lota09/AutoExhaust/docs/ESP32_C3_Pinmap.png

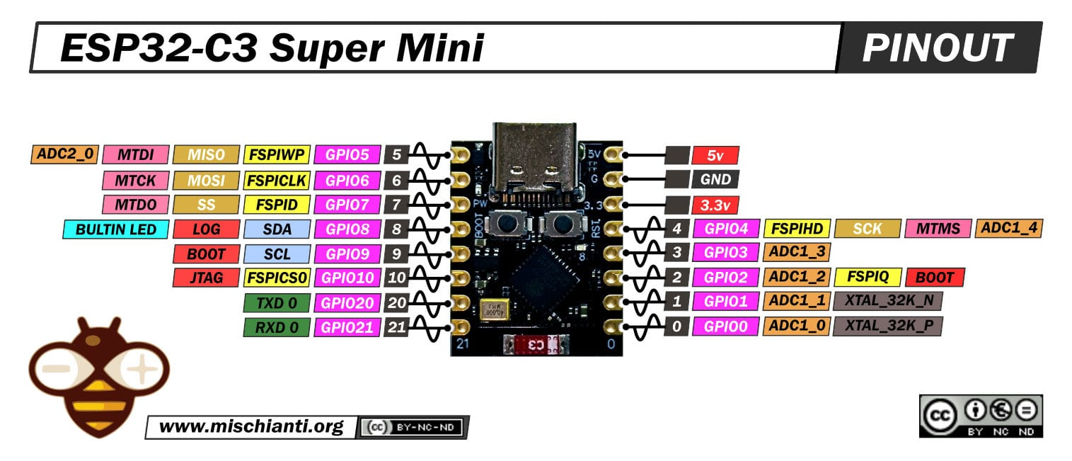
docs/ESP32_C3_Pinmap.png
