lota09/AutoExhaust/docs/ESP32_C3_Pinmap_rear.png

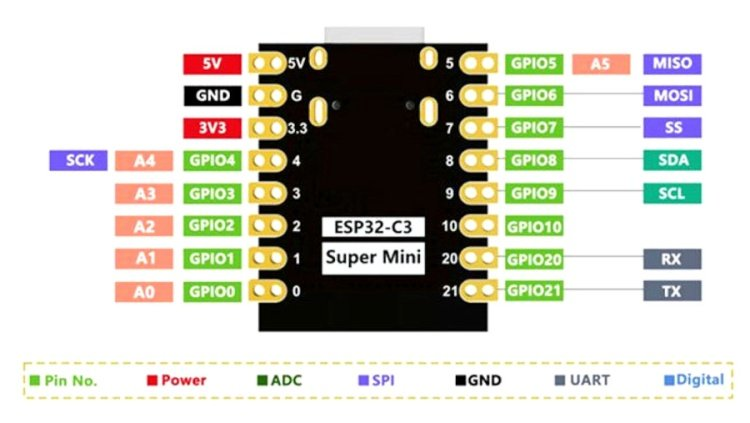
docs/ESP32_C3_Pinmap_rear.png
