lota09/AutoExhaust/hardware/bom/voltage_solution.pdf

# 전압 변환 솔루션 (Voltage Converters Comparison)

다양한 DC-DC 컨버터 모듈의 스펙과 특징을 비교하는 문서입니다.

📊 스펙 비교표

제품명 | 유형

입력 전압
(Input)

출력 전압
(Output)

최대 전
류

효율
(Max)

단가 (약) 특징 & 비고

Mini-360

Buck
(감압)

DC 4.75V
~ 23V

DC 1.0V ~
17V

3A
(Peak)
1.8A
(Cont)

96% 350원

초소형
(17x11mm), 동기

식 정류
장시간 사용시
1.8A 제한

MP1584EN

Buck
(감압)

DC 4.5V
~ 28V

DC 0.8V ~
20V
3A | 92% | 583원

초소형
(22x17mm), 고주
파(1.5MHz)
저전압 리플, 역극
성/무부하 주의

LM2596

Buck
(감압)

DC 3.2V
~ 35V

DC 1.25V
~ 30V

3A 92%

680~1,030

원

입력전압이 출력보
다 1.5V 높아야 함
단락/과열 보호, 전
원 LED 장착

MT3608

Boost
(승압)

DC 2V ~
24V

DC 5V ~
28V

2A
(Peak)

93% 450원

Micro USB /
Type-C 입력 가능
초기 세팅 주의 (반
시계 20바퀴)

XL6009

Buck-Boost
(자동
승강압)

DC 3.8V
~ 32V

DC 1.25V
~ 35V

3A
(Max
4A)

<94%

800~1,130

원

입력 전압이 출력
보다 높거나 낮아
도 OK
태양광/차량용 전

압 안정화 최적

XL6019

Buck-Boost
(자동
승강압)

DC 5V ~
32V

DC 1.3V ~
35V

1.5A
(Cont)
Max
4A

94% 1,250원

XL6009의 개량형
(발열/노이즈 개선)
내장 MOSFET 성

능 향상

LTC3780

Buck-Boost
(자동
승강압)

DC 5V ~
32V

DC 1V ~
30V

8A
(Cont)
Max
10A
- 12,000원

끝판왕 (고출력
80W~130W)
단락 보호 O, 역극
성 보호 X

️ 제품 이미지 및 상세

26. 2. 14. 오후 7:19 | voltage_solution.md
file:///C:/Users/lota/Developments/3D_Firmware/BOM/voltage_solution.html | 1/8

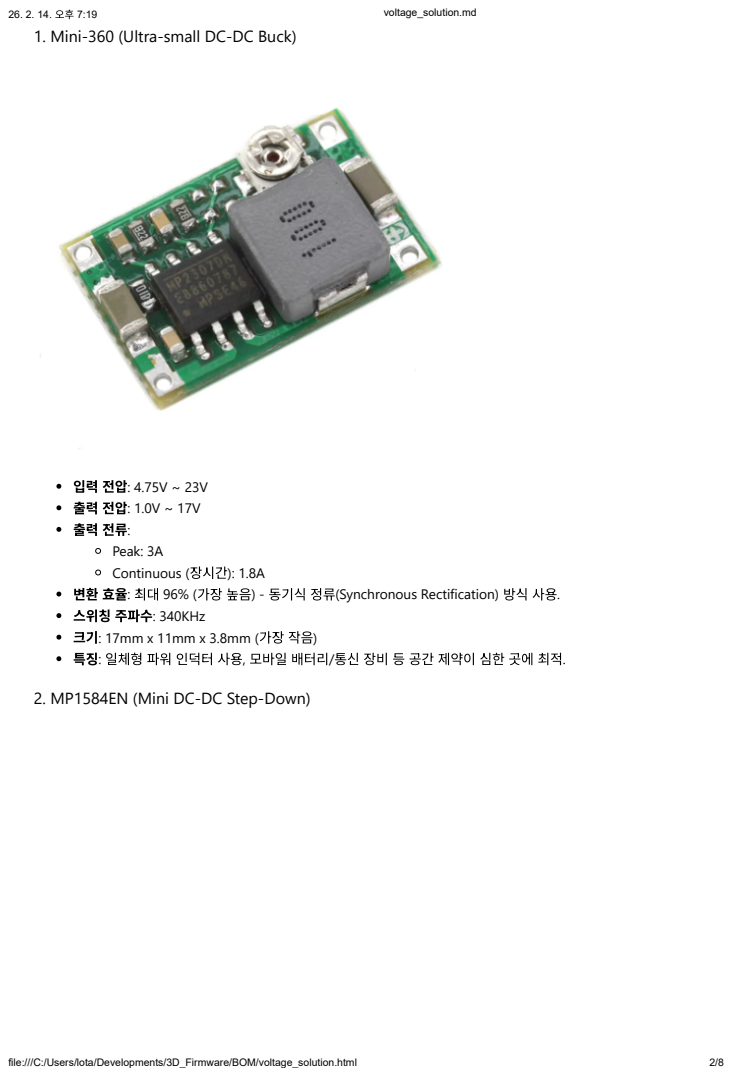
[picture p9: page 2]
file:///C:/Users/lota/Developments/3D_Firmware/BOM/voltage_solution.html

1. Mini-360 (Ultra-small DC-DC Buck)

Peak: 3A
Continuous (장시간): 1.8A
변환 효율: 최대 96% (가장 높음) - 동기식 정류(Synchronous Rectification) 방식 사용.
스위칭 주파수: 340KHz
특징: 일체형 파워 인덕터 사용, 모바일 배터리/통신 장비 등 공간 제약이 심한 곳에 최적.
2. MP1584EN (Mini DC-DC Step-Down)

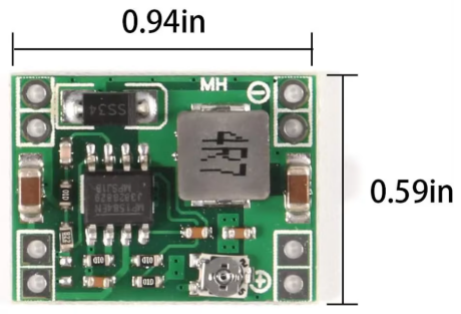
[picture p10: figure]

입력 전압: 4.5V ~ 28V (최대)
출력 전압: 0.8V ~ 20V (가변)
스위칭 주파수: 1.5MHz (일반 1MHz) - 고주파 동작으로 리플이 적음.
출력 리플: < 30mV
크기: 22mm x 17mm x 4mm (초소형)
주의사항:
역극성 금지: (+)와 (-)를 반대로 연결하면 즉시 파손됨.
무부하 금지: 부하가 없거나 너무 가벼운(10% 미만) 상태로 켜지 마세요.
3. LM2596 (DC-DC Step-Down)
file:///C:/Users/lota/Developments/3D_Firmware/BOM/voltage_solution.html | 3/8

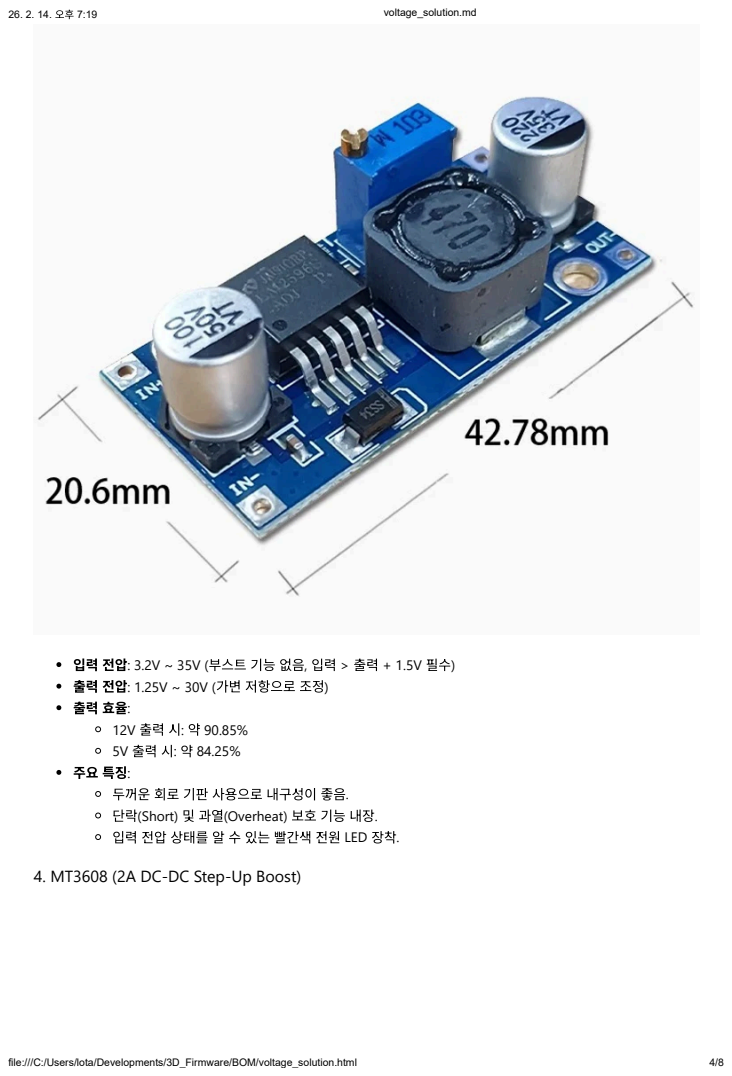
[picture p11: page 4]
file:///C:/Users/lota/Developments/3D_Firmware/BOM/voltage_solution.html

입력 전압: 3.2V ~ 35V (부스트 기능 없음, 입력 > 출력 + 1.5V 필수)
출력 전압: 1.25V ~ 30V (가변 저항으로 조정)
두꺼운 회로 기판 사용으로 내구성이 좋음.
단락(Short) 및 과열(Overheat) 보호 기능 내장.
입력 전압 상태를 알 수 있는 빨간색 전원 LED 장착.

4. MT3608 (2A DC-DC Step-Up Boost)

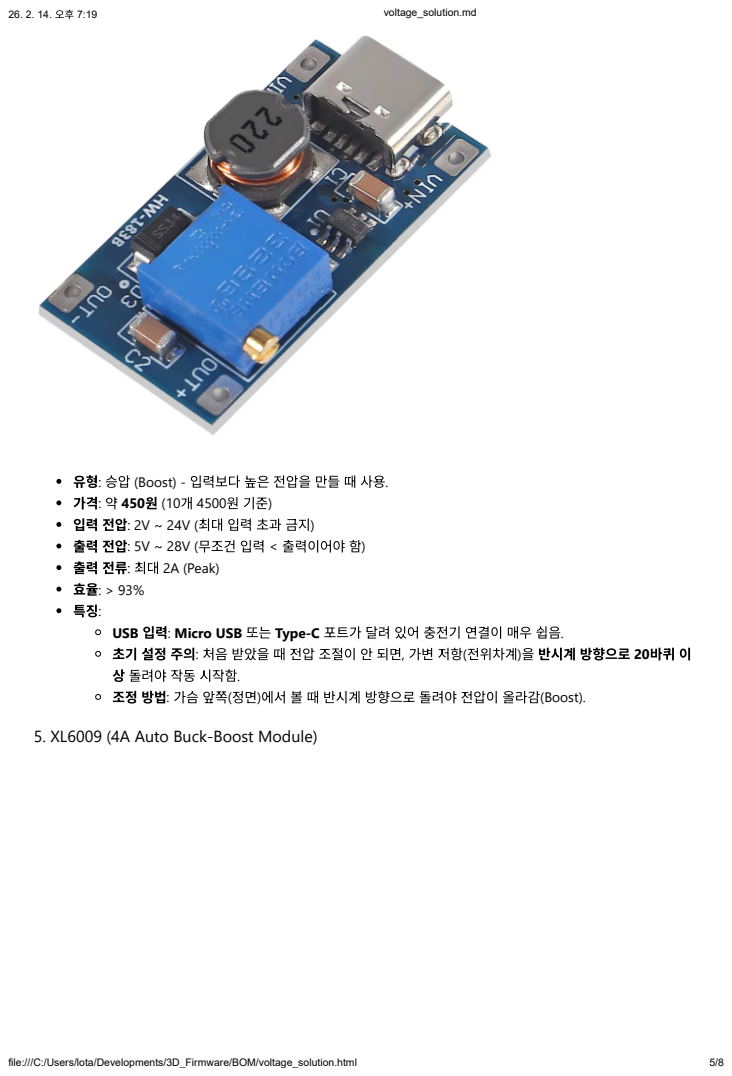
[picture p12: page 5]
file:///C:/Users/lota/Developments/3D_Firmware/BOM/voltage_solution.html

유형: 승압 (Boost) - 입력보다 높은 전압을 만들 때 사용.
출력 전압: 5V ~ 28V (무조건 입력 < 출력이어야 함)
출력 전류: 최대 2A (Peak)
USB 입력: Micro USB 또는 Type-C 포트가 달려 있어 충전기 연결이 매우 쉽음.
초기 설정 주의: 처음 받았을 때 전압 조절이 안 되면, 가변 저항(전위차계)을 반시계 방향으로 20바퀴 이
상 돌려야 작동 시작함.
조정 방법: 가슴 앞쪽(정면)에서 볼 때 반시계 방향으로 돌려야 전압이 올라감(Boost).

5. XL6009 (4A Auto Buck-Boost Module)

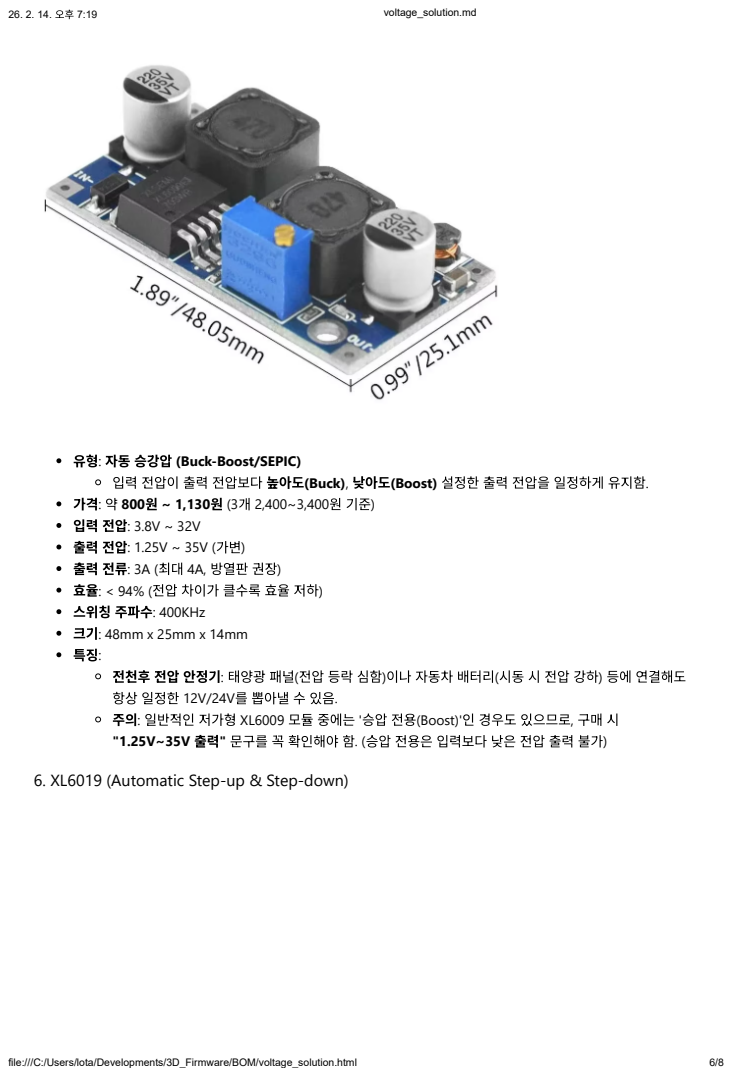
[picture p13: page 6]
file:///C:/Users/lota/Developments/3D_Firmware/BOM/voltage_solution.html

유형: 자동 승강압 (Buck-Boost/SEPIC)
입력 전압이 출력 전압보다 높아도(Buck), 낮아도(Boost) 설정한 출력 전압을 일정하게 유지함.
출력 전류: 3A (최대 4A, 방열판 권장)
효율: < 94% (전압 차이가 클수록 효율 저하)
스위칭 주파수: 400KHz
전천후 전압 안정기: 태양광 패널(전압 등락 심함)이나 자동차 배터리(시동 시 전압 강하) 등에 연결해도
항상 일정한 12V/24V를 뽑아낼 수 있음.
주의: 일반적인 저가형 XL6009 모듈 중에는 '승압 전용(Boost)'인 경우도 있으므로, 구매 시
"1.25V~35V 출력" 문구를 꼭 확인해야 함. (승압 전용은 입력보다 낮은 전압 출력 불가)

6. XL6019 (Automatic Step-up & Step-down)

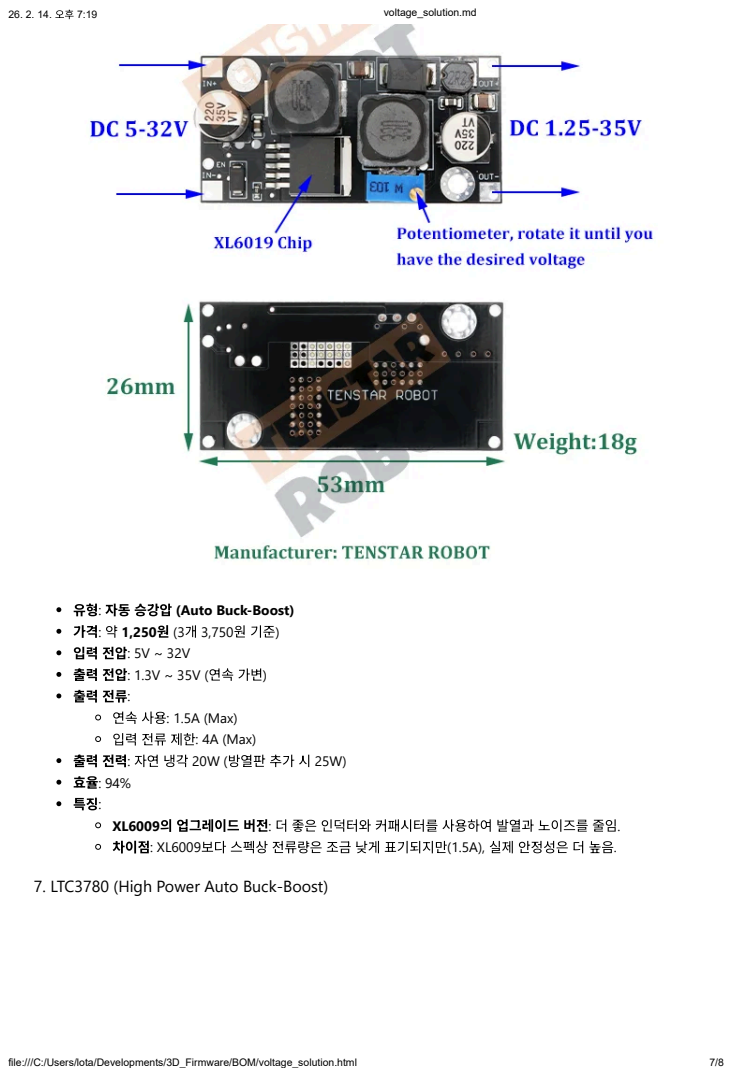
[picture p14: page 7]
file:///C:/Users/lota/Developments/3D_Firmware/BOM/voltage_solution.html

유형: 자동 승강압 (Auto Buck-Boost)
연속 사용: 1.5A (Max)
입력 전류 제한: 4A (Max)
출력 전력: 자연 냉각 20W (방열판 추가 시 25W)
XL6009의 업그레이드 버전: 더 좋은 인덕터와 커패시터를 사용하여 발열과 노이즈를 줄임.
차이점: XL6009보다 스펙상 전류량은 조금 낮게 표기되지만(1.5A), 실제 안정성은 더 높음.

7. LTC3780 (High Power Auto Buck-Boost)

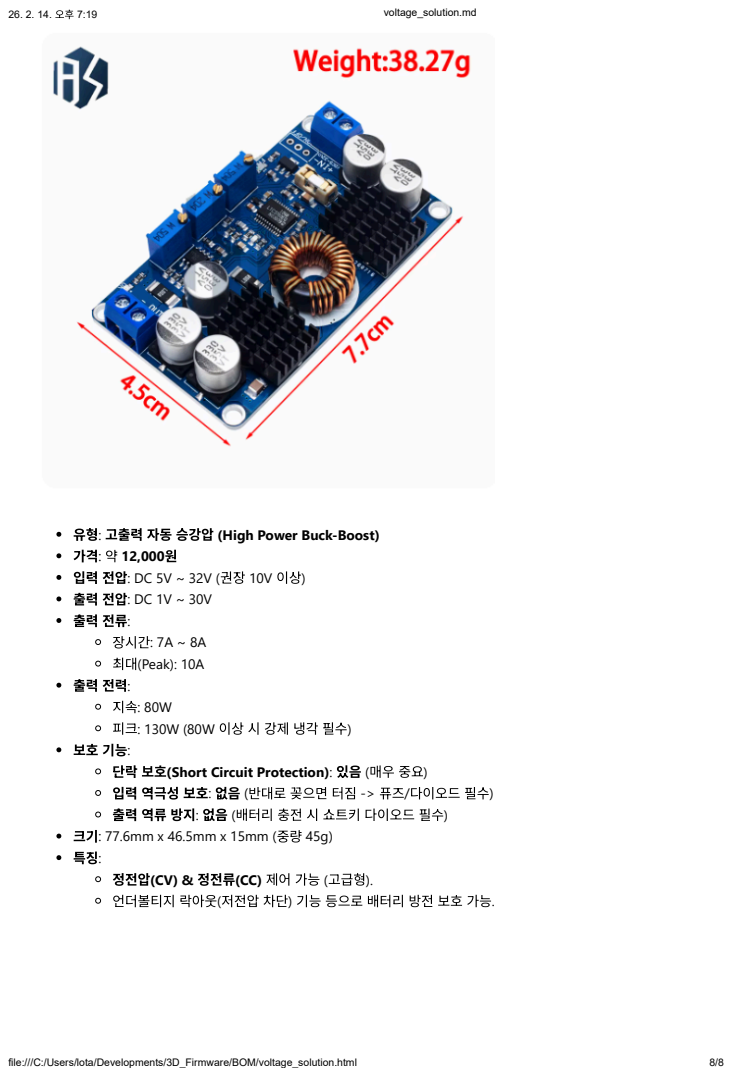
[picture p15: page 8]
file:///C:/Users/lota/Developments/3D_Firmware/BOM/voltage_solution.html

유형: 고출력 자동 승강압 (High Power Buck-Boost)
장시간: 7A ~ 8A
최대(Peak): 10A
단락 보호(Short Circuit Protection): 있음 (매우 중요)
입력 역극성 보호: 없음 (반대로 꽂으면 터짐 -> 퓨즈/다이오드 필수)
출력 역류 방지: 없음 (배터리 충전 시 쇼트키 다이오드 필수)
정전압(CV) & 정전류(CC) 제어 가능 (고급형).
언더볼티지 락아웃(저전압 차단) 기능 등으로 배터리 방전 보호 가능.
