lota09/AutoExhaust/hardware/bom/LTC3780.png

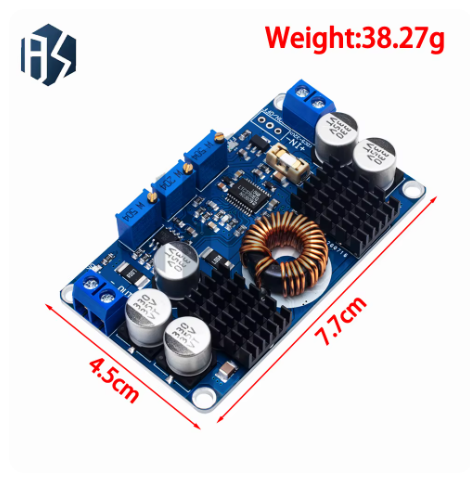
hardware/bom/LTC3780.png
