lota09/AutoExhaust/hardware/bom/MT3608.png

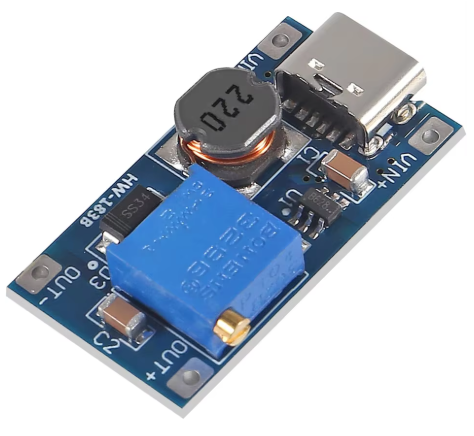
hardware/bom/MT3608.png
