lota09/AutoExhaust/hardware-tests/WiFi_Signal_Analyzer/signal_strength.md

## New Device : bare

```
22:06:11.944 -> Local: -66.0 dBm | Remote: -100.0 dBm
22:06:16.927 -> Local: -62.0 dBm | Remote: -100.0 dBm
22:06:21.965 -> Local: -68.0 dBm | Remote: -100.0 dBm
22:06:26.929 -> Local: -62.0 dBm | Remote: -100.0 dBm
22:06:31.957 -> Local: -71.0 dBm | Remote: -100.0 dBm
22:06:36.977 -> Local: -71.0 dBm | Remote: -100.0 dBm
22:06:41.987 -> Local: -71.0 dBm | Remote: -100.0 dBm
22:06:46.966 -> Local: -66.0 dBm | Remote: -100.0 dBm
22:06:51.975 -> Local: -70.0 dBm | Remote: -100.0 dBm
22:06:57.036 -> Local: -68.0 dBm | Remote: -100.0 dBm
22:07:02.011 -> Local: -77.0 dBm | Remote: -100.0 dBm
22:07:07.006 -> Local: -69.0 dBm | Remote: -100.0 dBm
22:07:12.044 -> Local: -67.0 dBm | Remote: -100.0 dBm
```

## New Device : bshape_antenna

```
..........
WiFi Connected: 192.168.50.161
Local: -64.0 dBm | Remote: -100.0 dBm
Local: -61.0 dBm | Remote: -100.0 dBm
Local: -61.0 dBm | Remote: -100.0 dBm
Local: -64.0 dBm | Remote: -100.0 dBm
Local: -67.0 dBm | Remote: -100.0 dBm
Local: -62.0 dBm | Remote: -100.0 dBm
Local: -65.0 dBm | Remote: -100.0 dBm
Local: -66.0 dBm | Remote: -100.0 dBm
Local: -64.0 dBm | Remote: -100.0 dBm
Local: -64.0 dBm | Remote: -100.0 dBm
Local: -64.0 dBm | Remote: -100.0 dBm
Local: 0.0 dBm | Remote: -100.0 dBm
Local: -65.0 dBm | Remote: -100.0 dBm
Local: -65.0 dBm | Remote: -100.0 dBm
Local: -65.0 dBm | Remote: -100.0 dBm
Local: -65.0 dBm | Remote: -100.0 dBm
Local: -65.0 dBm | Remote: -100.0 dBm
Local: -65.0 dBm | Remote: -100.0 dBm
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
Local: -74.0 dBm | Remote: -100.0 dBm
Local: -73.0 dBm | Remote: -100.0 dBm
Local: -73.0 dBm | Remote: -100.0 dBm
Local: -86.0 dBm | Remote: -100.0 dBm
Local: -77.0 dBm | Remote: -100.0 dBm
Local: -71.0 dBm | Remote: -100.0 dBm
Local: -76.0 dBm | Remote: -100.0 dBm
```

## Phoenix(old) Device : Wshape_antenna_L
```
22:58:59.082 -> .......................................................................................................
22:59:50.846 -> WiFi Connected: 192.168.50.75
22:59:50.846 -> mDNS responder started: http://wifianalyzer.local
23:00:02.865 -> Local: -79.0 dBm | Remote: -100.0 dBm
23:00:09.865 -> Local: -73.0 dBm | Remote: -100.0 dBm
23:00:16.877 -> Local: -74.0 dBm | Remote: -100.0 dBm
23:00:23.863 -> Local: -81.0 dBm | Remote: -100.0 dBm
```
