lota09/AutoExhaust/hardware-tests/WiFi_Stability/logs/boot_test_20261027_142339.csv

trial | profile | boot_connect_ms | failed_attempts | web_up_s | mqtt_up_s | rssi_now | rssi_avg | tx_dbm | channel
1 | P1 | 5155 | 0 | 10 | 10 | -70 | -70.4 | 19.5 | 6
2 | P2 | 5088 | 0 | 9 | 9 | -70 | -70.5 | 11.0 | 6
3 | P3 | 5091 | 0 | 8 | 8 | -47 | -69.0 | 8.5 | 6
4 | P2 | 4582 | 0 | 8 | 8 | -71 | -71.7 | 11.0 | 6
5 | P3 | 5097 | 0 | 8 | 9 | -71 | -71.3 | 8.5 | 6
6 | P1 | 5120 | 0 | 9 | 9 | -72 | -72.0 | 19.5 | 6
7 | P3 | 5152 | 0 | 8 | 8 | -73 | -71.5 | 8.5 | 6
8 | P1 | 5129 | 0 | 10 | 10 | -73 | -72.1 | 19.5 | 6
9 | P2 | 5123 | 0 | 9 | 9 | -72 | -71.7 | 11.0 | 6
10 | P1 | 5122 | 0 | 8 | 9 | -71 | -71.6 | 19.5 | 6
11 | P2 | 5122 | 0 | 9 | 9 | -72 | -72.0 | 11.0 | 6
12 | P3 | 5122 | 0 | 8 | 8 | -72 | -71.9 | 8.5 | 6
13 | P2 | 4591 | 0 | 8 | 8 | -73 | -71.2 | 11.0 | 6
14 | P3 | 5094 | 0 | 8 | 9 | -73 | -72.4 | 8.5 | 6
15 | P1 | 5115 | 0 | 9 | 9 | -73 | -72.9 | 19.5 | 6
