lota09/AutoExhaust/docs/powerfailure_solution.md

# ⚡ 전원 보호 솔루션 및 MOSFET 심층 분석

본 문서는 MOSFET 모듈의 종류, 작동 원리(물성), 그리고 MCU를 고전압 사고로부터 보호하기 위한 회로 설계 전략을 다룹니다. 특히 **포토커플러(Optocoupler)**를 활용한 절연 방식과 **N-Channel MOSFET** 구동 원리에 집중합니다.

---

## 1. 포토커플러 (Optocoupler)의 원리

포토커플러는 **"빛을 이용해 신호를 전달하는 소자"**입니다. 전기적으로 완전히 분리된 두 회로를 연결할 때 사용합니다.

### 🔬 구조 및 작동 원리 (PC817 기준)
*   **왼쪽 (입력부: 송신)**: **적외선 LED**
    *   MCU가 신호(High)를 주면 LED가 켜집니다.
    *   반드시 전류 제한 저항(220Ω~1kΩ)이 필요합니다.
*   **중간 (절연체)**: 투명한 **유리/플라스틱**
    *   전기가 통하지 않습니다. (빛만 통과)
    *   입력부에서 수천 볼트 스파크가 튀어도 출력부로 넘어갈 수 없습니다.
*   **오른쪽 (출력부: 수신)**: **포토 트랜지스터(Photo-Transistor)**
    *   빛을 받으면 내부에 전자가 생성되어 스위치가 켜집니다(Collector → Emitter 도통).
    *   빛이 없으면 전기가 통하지 않습니다(Switch OFF).

---

## 2. MOSFET 모듈의 종류와 차이점

시중에는 크게 두 가지 형태의 MOSFET 모듈이 존재합니다.

### A. 듀얼 MOSFET 모듈 (비절연형)
*   **대표 모델**: D4184, LR7843 등 (파란색 단자대, 방열판 없음)
*   **구조**: MCU 핀이 저항 하나를 거쳐 MOSFET의 **Gate**와 직결됨.
*   **특징**:
    *   **장점**: 매우 저렴함(200~300원), 반응 속도가 빠름(ns 단위).
    *   **단점**:
        *   **MCU 전압(3.3V/5V)으로 구동**: MOSFET 성능을 100% 발휘 못함 (발열 증가).
        *   **위험성**: MOSFET이 파괴되면 고전압(12V/24V)이 Gate를 타고 MCU로 역류하여 **보드 전체 사망**.

### B. 절연 MOSFET 모듈 (절연형)
*   **대표 모델**: FR120N, LR7843 절연형 (녹색 단자대, PC817 탑재)
*   **구조**: [MCU 신호] → [**포토커플러**] → [12V/24V 전원] → [MOSFET Gate]
*   **특징**:
    *   **장점**:
        *   **MCU 완벽 보호**: 고전압 사고 시 포토커플러만 죽고 MCU는 생존.
        *   **풀파워 구동**: MCU 전압이 아닌 **12V/24V 전원**을 끌어와 Gate를 셌게 열어줌 ($R_{DS(on)}$ 최소화, 발열 감소).
    *   **단점**: 가격이 비쌈(600~1000원), 반응 속도가 상대적으로 느림(μs 단위, ~20kHz).

---

## 3. MOSFET의 물성과 구동 방식

### 💡 왜 대부분 N-Channel MOSFET (Low-Side)을 쓰는가?
부하의 (+)를 끊는 것(High-Side)보다 **(-)를 끊는 것(Low-Side)**이 압도적으로 유리하기 때문입니다.

1.  **동작 조건 ($V_{GS}$)**
    *   N-MOSFET은 **Gate 전압이 Source 전압보다 10V 높아야($V_{GS} > 10V$)** 완전히 켜집니다.
2.  **Low-Side (N-MOS)의 경우**:
    *   **Source**가 **GND(0V)**에 묶여 있습니다.
    *   **Gate**에 **10V**만 주면 켜집니다. (회로 간단)
3.  **High-Side (N-MOS)의 경우**:
    *   **Source**가 부하 때문에 **떠 있습니다.**
    *   스위치를 켜면 Source 전압이 24V로 올라가 버립니다.
    *   계속 켜려면 Gate에 **34V (24V + 10V)**를 줘야 합니다. (승압 회로 필요 → 비쌈)
4.  **P-Channel MOSFET**:
    *   High-Side 제어가 쉽지만, N-MOS 대비 **가격 3배, 성능(전류 용량) 절반**이라 잘 안 씁니다.

### 🔍 절연 모듈에 있는 '빨간 다이오드'의 정체
*   **제너 다이오드 (Zener Diode)**: Gate와 Source 사이에 병렬로 연결됨.
*   **역할**: 절연 모듈은 24V를 Gate 구동 전원으로 씁니다. 하지만 Gate는 20V 넘으면 터집니다.
*   **작동**: 24V가 들어오면 제너 다이오드가 **"15V 이상은 내가 먹을게(Clamping)"** 하여 Gate 전압을 15V로 유지, MOSFET을 보호합니다.

---

## 4. [DIY 솔루션] 듀얼 모듈을 위한 안전장치 회로

기존 듀얼 모듈(비절연)을 버리지 않고, **트랜지스터(2N7000)** 하나로 **절연 모듈급 성능과 안전성**을 확보하는 회로입니다.

### 🛠️ 회로 구성 (NPN 트랜지스터 활용)
이 회로는 **Low-Active** 방식(MCU Low일 때 팬 켜짐)으로 동작합니다.

1.  **Gate 드라이버 (2N7000/NPN)**
    *   **Base(Gate)**: MCU 핀과 연결 (보호저항 1kΩ 추가 추천)
    *   **Emitter(Source)**: GND 연결
    *   **Collector(Drain)**: 듀얼 모듈의 **신호 입력(SIG)** 핀에 연결
2.  **풀업 저항 (10kΩ)**
    *   **12V/24V 전원(+)**와 **듀얼 모듈 SIG 핀** 사이에 연결.
    *   역할: 2N7000이 꺼졌을 때, 12V/24V를 Gate로 보내 **강력하게 턴온** 시킴.

### 🛡️ 안전 분석 (사고 시나리오)
만약 24V 라인에 **50V 스파크**가 튀면 어떻게 되는가?

*   **상황**: 2N7000이 켜져 있는 상태 (팬 꺼짐 명령 중)
*   **10kΩ 풀업 저항의 역할**:
    *   50V 고전압이 들어와도 **10kΩ 저항**이 전압 대부분을 감당합니다.
    *   전류량 제한: $I = 50V / 10,000\Omega = \mathbf{5mA}$.
    *   2N7000으로 흐르는 전류는 고작 5mA뿐이며, **Drain 전압은 거의 0V**로 유지됩니다.
    *   MCU 쪽으로는 아무런 영향이 가지 않습니다.
*   **만약 2N7000이 터진다면?**:
    *   최후의 보루로 MCU 핀 앞에 달아둔 **1kΩ 저항**이 과전류를 막아줍니다.

---

## 5. 결론 및 요약

1.  **PC817**: 빛으로 신호를 전달하여 MCU와 고전압 회로를 완벽하게 격리하는 **최고의 안전장치**.
2.  **절연 모듈**: 12V/24V 전원을 Gate 구동에 사용하여 **발열이 적고 힘이 좋음**. (제너 다이오드로 Gate 보호)
3.  **듀얼 모듈(비절연)**: MCU 전압으로 구동하므로 성능 저하 및 역류 위험 존재.
4.  **DIY 회로**: **[2N7000 + 10kΩ 풀업]** 조합을 쓰면 듀얼 모듈도 **고전압 구동(풀파워)** 및 **MCU 보호**가 가능함.
