lota09/AutoExhaust/docs/notes/esp32_c3_wifi_failure.md

# 🦅 ESP32-C3 SuperMini 외부 간섭 및 기적적 부활 보고서

## 1. 상황 (Situation)
*   **하드웨어 구성**: 
    *   메인 보드: ESP32-C3 SuperMini
    *   전원부: 12V DC 입력 → Mini-360 벅 컨버터 (3.3V~3.5V 세팅)
*   **사고 발생**: 
    *   프로토타입 보드에 실장된 상태에서 Mini-360 역삽입 사고 발생.
    *   이후 USB 연결 시 LDO 발열, 고주파 비명, 연기 발생 및 WiFi 연결(Reason 2, 201, 36) 지속 실패.
    *   **사망 판정**: 하드웨어 파손으로 결론짓고 폐기 직전까지 감.

## 2. 반전 및 결과 (The Resurrection)
*   **적극적 조치**: 다른 보드로 교체하기 위해 해당 ESP32-C3를 **프로토타입 보드에서 완전히 탈거(분리)**.
*   **기적적 부활**: 
    *   단독 상태에서 USB 연결 시 **발열 및 고주파음 즉시 사라짐**.
    *   **WiFi 연결 성공**: 표준 코드로 공유기 및 스마트폰 핫스팟에 즉시 연결됨.
    *   **SoftAP 확인**: `HELP-ME-C3` 신호가 스마트폰 목록에 정상 노출됨.
*   **최종 결론**: **칩 자체는 불사신이었으며, 범인은 외부(프로토타입 보드)에 있었음.**

## 3. 원인 재분석 (Revised Root Causes)

### A. 전원 역류 현상 (Back-feeding through Mini360)
*   **메커니즘**: USB 5V 연결 시 ESP32의 LDO가 생성한 3.3V 전압이 Mini360의 출력단(OUT+)으로 유입됨.
*   **결과**: Mini360 내부의 바디 다이오드를 타고 입력단(IN+, 12V 버스)으로 역류 발생.
*   **실험 증명**: 출력 노드에 3.3V 인가 시 **순간 전류가 최대 1A까지** 치솟으며 12V 라인의 커패시터들을 급격히 충전 시도함 확인. 
*   **증상 연결**: 이 과부하가 ESP32의 LDO(최대 0.5A)를 고문하여 **심한 발열과 무한 재부팅 루프**를 유발. (디코이 모듈의 비명 소리 동반)

### C. 물리적 배치에 따른 안테나 디튜닝 (Antenna Detuning)
*   **발견**: 동일한 칩이라도 주변 금속물(핀헤더, 프로토타입 보드 배선)의 유무에 따라 WiFi 연결 성능이 극명하게 차이 남.
    *   Bare Board: 5초 이내 연결
    *   프로토타입 보드 실장: 40초 이상 소요 또는 연결 불가
*   **원인**: ESP32-C3 SuperMini의 초소형 세라믹 안테나가 주변의 핀헤더와 구리 패턴에 의해 **임피던스 불일치(Detuning)** 및 신호 차폐 현상을 겪음. [참고자료](https://www.elektormagazine.com/labs/esp32-c3-supermini-antenna-mod)
*   **기묘한 반전 (Human Antenna Effect)**: 안테나 부위를 손으로 쓰다듬거나 접촉할 경우 연결 속도가 **5~15초로 획기적으로 향상**됨. 이는 인체가 안테나의 연장선 혹은 튜닝 보정기 역할을 하여 신호를 강제로 외부로 유도했기 때문임.

## 4. 재발 방지 및 향후 대책 (New Lessons)

### 🛡️ 하드웨어 보호 및 RF 최적화
*   **역류 방지**: 벅 컨버터 출력단(OUT+)에 **쇼트키 다이오드(1n5819)**를 추가하여 USB 전원의 외부 역류를 물리적으로 차단.
*   **안테나 이격**: 프로토타입 보드 설계 시 안테나 영역 아래에는 구리 패턴이나 배선을 두지 않으며, 가급적 안테나 부위가 보드 밖으로 튀어나오는 **Overhang** 구조 선택.
*   **안테나 개조**: 수신 성능이 극도로 중요한 경우 31mm 와이어를 통한 1/4 파장 안테나 증설 고려.
*   **GND 통합 주의**: 전위차가 큰 두 시스템의 GND를 결합할 때는 항상 미세 전류 유입 가능성을 염두에 둘 것.

---
**최종 결론**: 본 사고는 칩 파손이 아닌 **'전원 계통간의 상호 간섭'**과 **'물리적 배치에 의한 RF 성능 저하'**가 결합된 복합적 일시 마비 현상이었음.
"안테나를 쓰다듬어 부활시킨" 기묘한 경험을 통해 RF 설계에서 안테나 주변 환경이 미치는 영향이 얼마나 절대적인지 확인한 하드웨어 디버깅의 정석적 사례임.
