lota09/AutoExhaust/docs/notes/esp32_c3_wifi_failure.png

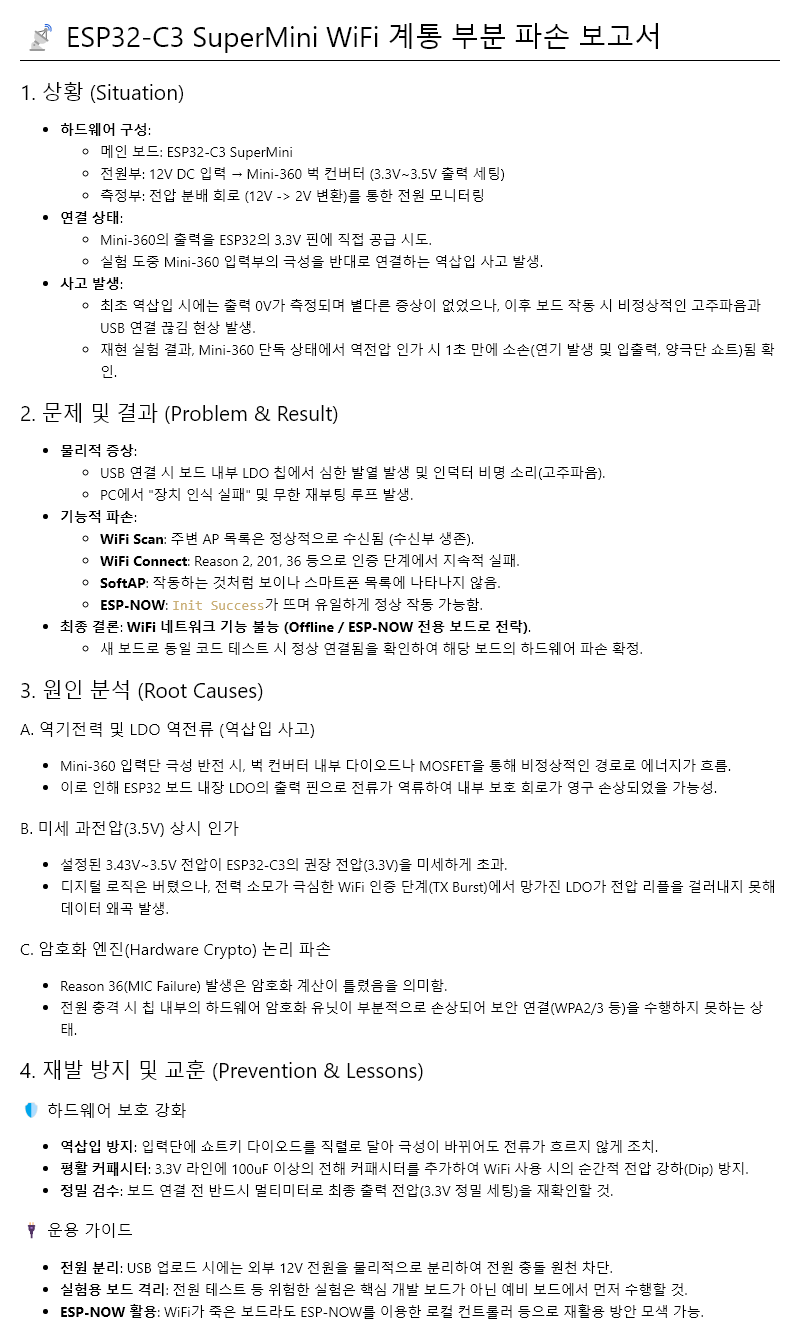
docs/notes/esp32_c3_wifi_failure.png
