lota09/AutoExhaust/(commit log)

2026-10-28 AutoExhaust 2.0 firmware rework: no sleep, new state machine, REST API
    - Remove all sleep (modem/light); WiFi TX 11 dBm, disconnect logging,
    reconnect watchdog (from Hardware_Test/WiFi_Stability results)
    - Fix MQTT connect without credentials; pushall on connect
    - States BOOT/IDLE/RUNNING/COOLDOWN/MANUAL/OFFLINE/FAULT with run-on,
    offline hold and latching undervoltage/overheat fault
    - Load limits, light soft ramp, 25 kHz fan PWM with kick-start
    - Button actions on release; built-in LED shows WiFi status only
    - Settings persisted in NVS; REST API (docs/API.md); chamber light sync
    - Partition scheme min_spiffs (1.9MB app with OTA)
    - WiFi stability test sketch and scripts, docs update
    Co-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
2026-10-28 OTA rollback, new web dashboard, button reboot removed
    - New OTA images stay pending until WiFi + web/OTA are healthy for 60 s,
    otherwise the bootloader rolls back (tested with --selftest-fail)
    - ota.sh: compile, upload, verify via /api/status; firmware version in API
    - Web UI rewritten as a static page on top of /api/* (live refresh)
    - Remove 10 s button reboot (mechanical switch covers it)
2026-10-28 Terminal FAULT with deep sleep, crash records, loop watchdog
    - FAULT (undervoltage, chip overheat, crash loop) saves a record to NVS,
    holds loads low and RGB in the fault color, then deep sleeps until a
    power cycle; web UI shows the last fault/crash until acknowledged
    - Loop watchdog (60 s), crash-loop detection, core dump summary (task/PC/RA)
    - /api/fault/ack and /api/test; ota.sh keeps the ELF of each build
    - Flow doc rewritten around state transition conditions
2026-10-28 Web UI state colors (IDLE blue, RUNNING green, COOLDOWN cyan); no chamber light ON when joining a print in progress
2026-10-28 Restructure repo, add README and MIT license, drop ESP8266
    - firmware/ (AutoExhaust), hardware-tests/, hardware/, docs/notes/,
    samples/mqtt/; split esp32_test into one folder per sketch
    - ESP8266 code/docs and unrelated files are no longer tracked
    - README (Korean) for visitors, secrets.example.h, hardware/circuit.md
    replacing pinconf.md and the old circuit design stub
